Yirayi/DigitalCurrentPower/docs/PCB-.png

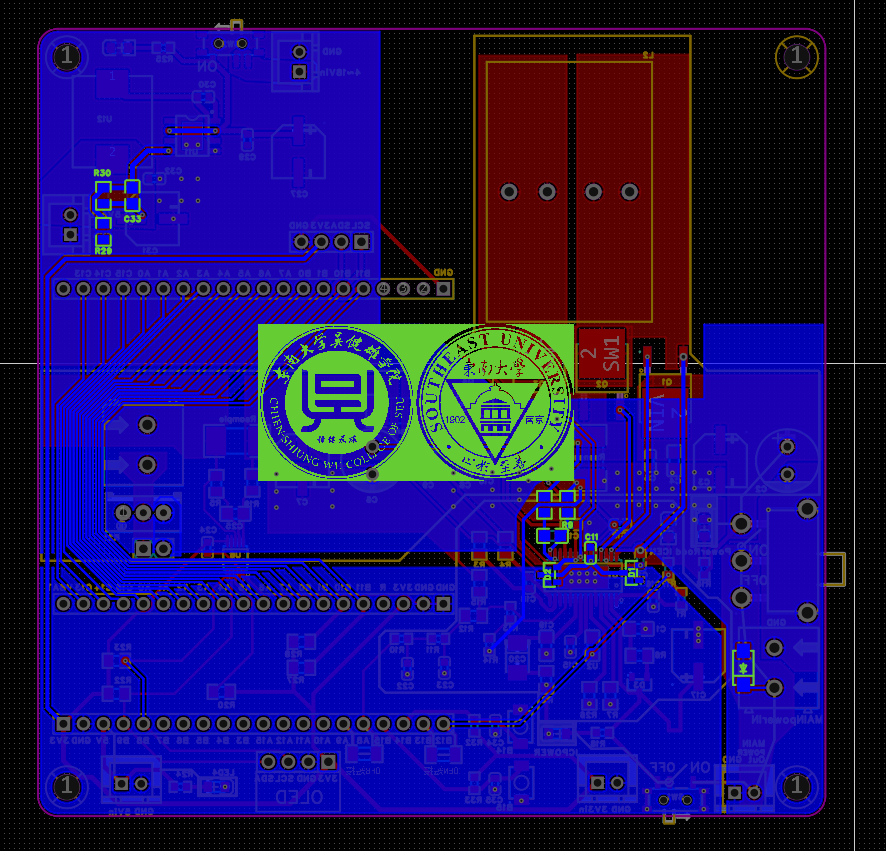
docs/PCB-.png
