Yirayi/DigitalCurrentPower/docs/主功率电路.png

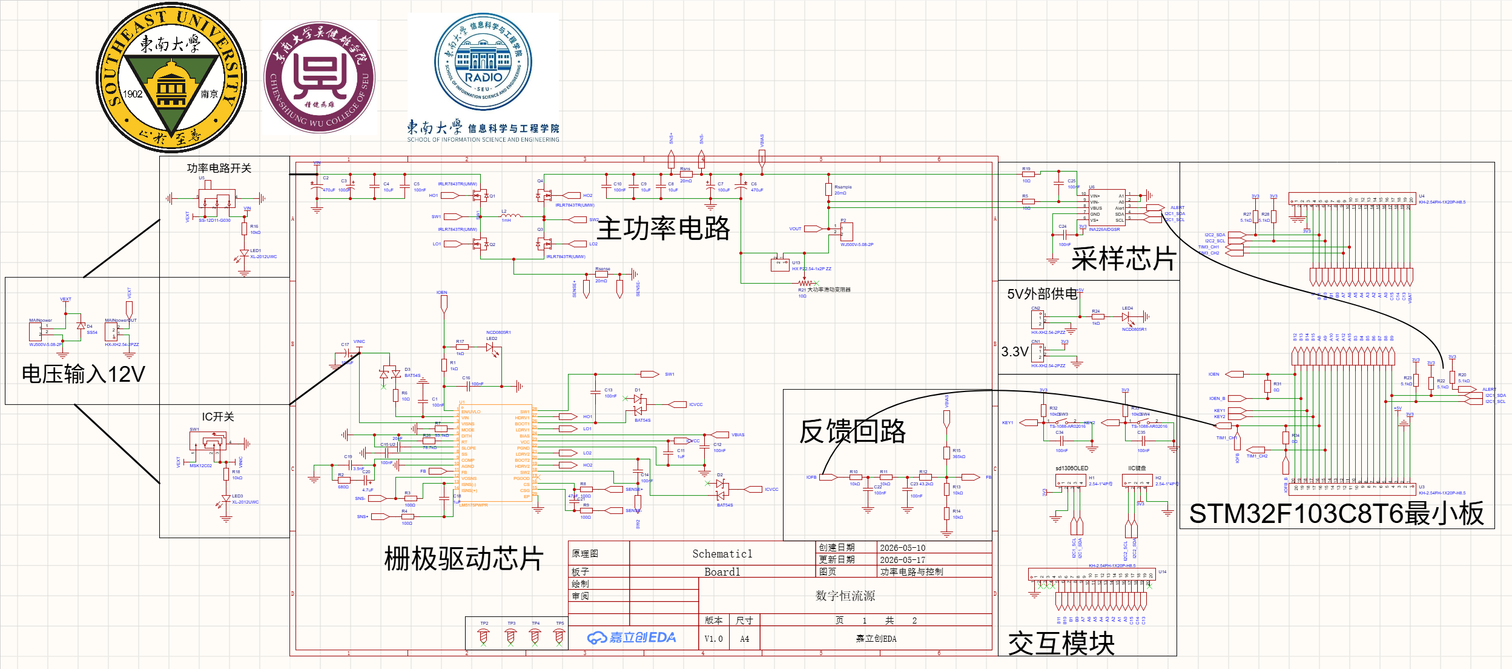
docs/主功率电路.png
