Yirayi/DigitalCurrentPower/docs/降压辅助电源.png

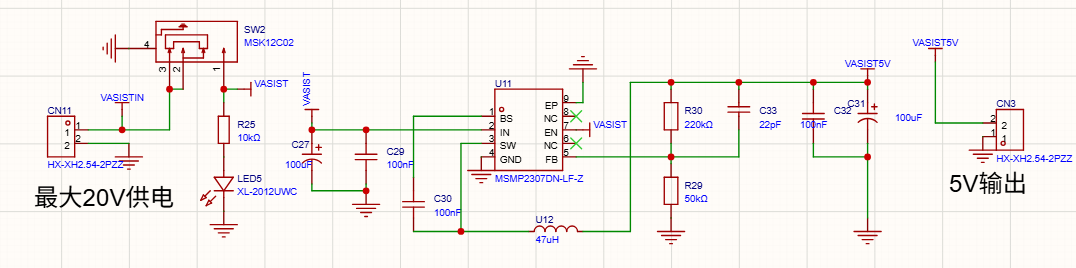
docs/降压辅助电源.png
