Yirayi/DigitalCurrentPower/DigitalCurrentPower.ioc

Mcu.UserName=STM32F103C8Tx
PA0-WKUP.Signal=ADCx_IN0
PA13.Signal=SYS_JTMS-SWDIO
PA14.Signal=SYS_JTCK-SWCLK
PA8.Signal=S_TIM1_CH1
PB10.Signal=I2C2_SCL
PB11.Signal=I2C2_SDA
PB12.GPIO_Label=IOEN
PB12.Signal=GPIO_Output
PB15.GPIO_Label=KeyDown
PB15.Signal=GPXTI15
PB5.GPIO_Label=AlertIn
PB5.Signal=GPXTI5
PB8.Signal=I2C1_SCL
PB9.Signal=I2C1_SDA
PC13-TAMPER-RTC.GPIO_Label=BoardLED
PC13-TAMPER-RTC.Signal=GPIO_Output
PD0-OSC_IN.Signal=RCC_OSC_IN
PD1-OSC_OUT.Signal=RCC_OSC_OUT
