Yirayi/DigitalCurrentPower/Core/Inc/main.h

#define BoardLED_Pin GPIO_PIN_13
#define BoardLED_GPIO_Port GPIOC
#define IOEN_Pin GPIO_PIN_12
#define IOEN_GPIO_Port GPIOB
#define KeyDown_Pin GPIO_PIN_15
#define KeyDown_GPIO_Port GPIOB
#define KeyDown_EXTI_IRQn EXTI15_10_IRQn
#define AlertIn_Pin GPIO_PIN_5
#define AlertIn_GPIO_Port GPIOB
#define AlertIn_EXTI_IRQn EXTI9_5_IRQn
