Yirayi/DigitalCurrentPower/(commit log)

2026-05-16 A good PID
2026-05-17 嘉立创工程提交
2026-05-17 docs: add system software design report
    Describe overall architecture, peripheral allocation, per-module design
    (INA226 state machine, OLED frame buffer, keyboard input, adaptive PID),
    and inter-module coordination including the I2C1 sharing strategy.
    https://claude.ai/code/session_01GeYaCTSZ6EqoXeUcZhXm47
